joachimwestlund/SignalGenerator/(list of files, cad)

Other CAD files:
3d/case/case.ipt
