joachimwestlund/SignalGenerator/SignalGenerator_schematic.pdf

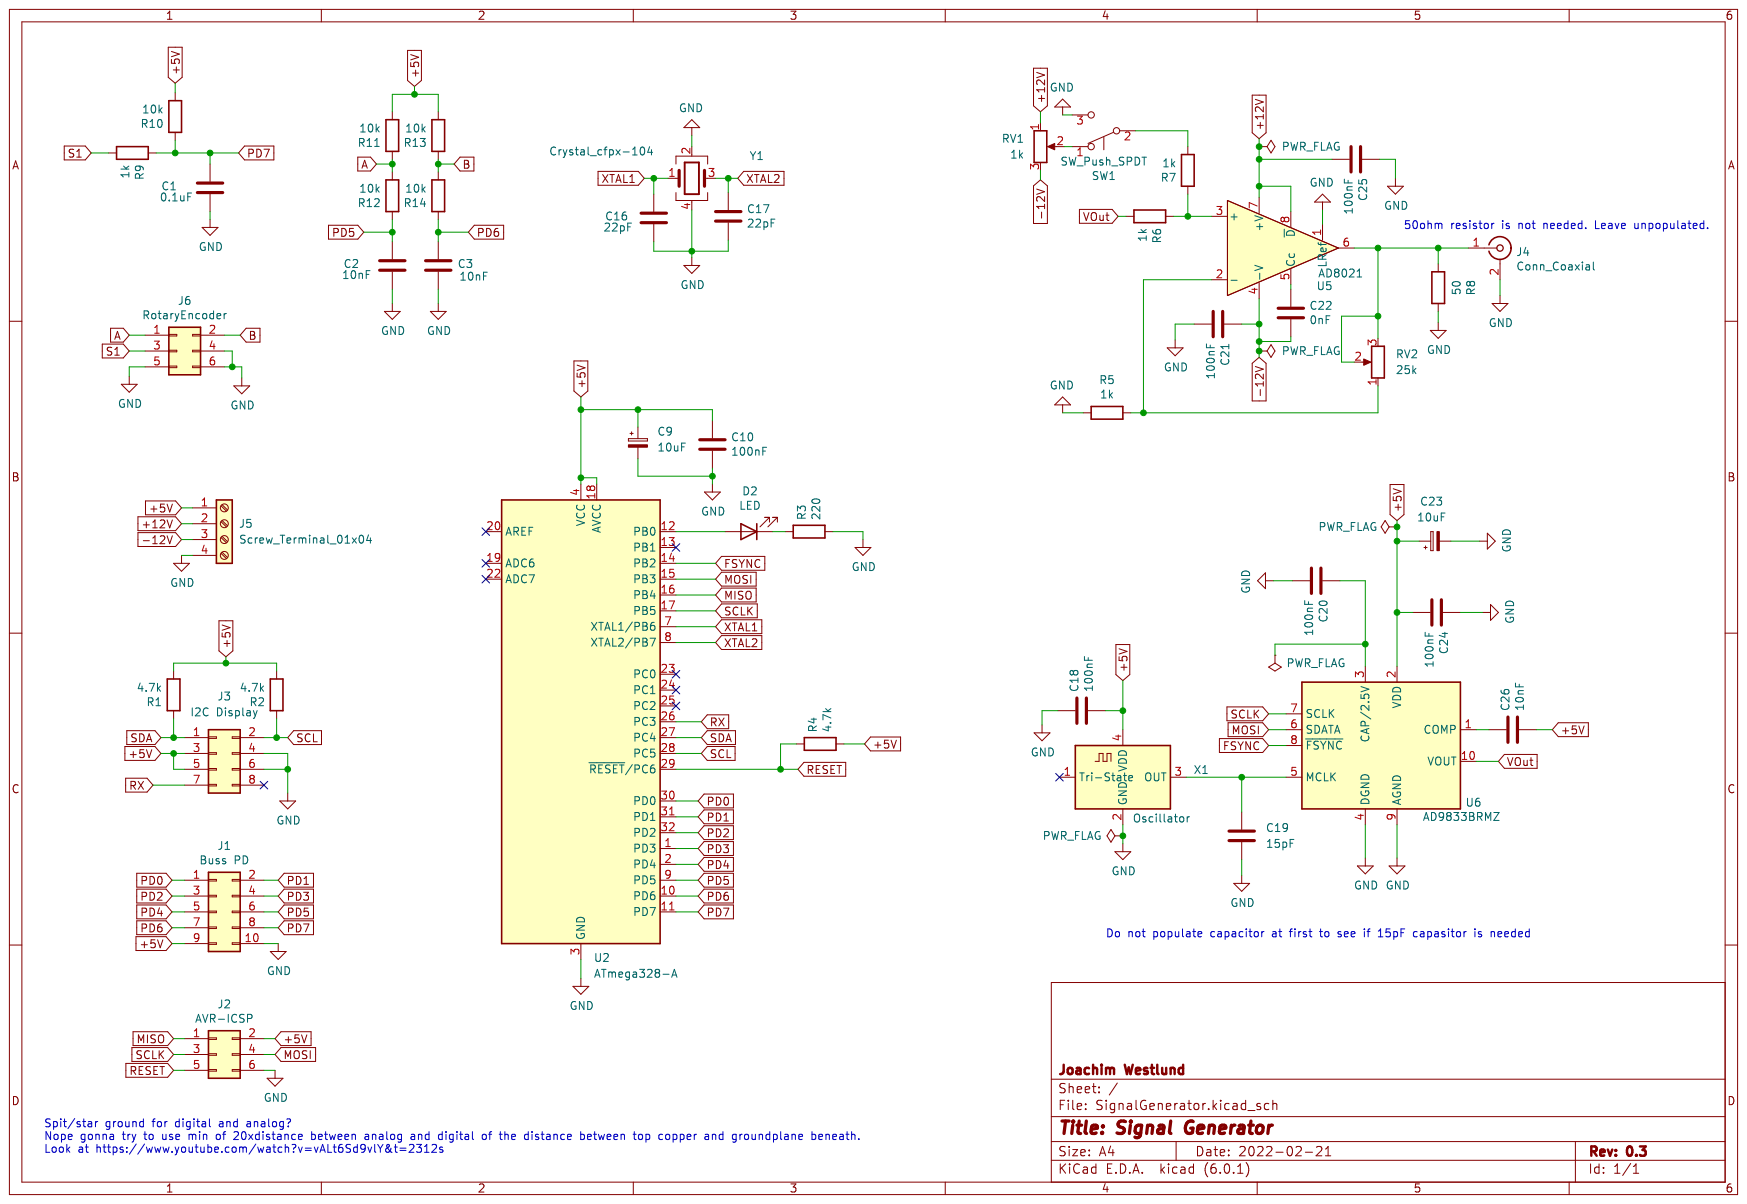
[picture p1: page 1]
