joachimwestlund/SignalGenerator/Sim/amplifier.asc

C1: cap; 1µ
R1: res; 1k
R3: res; 16k
R4: res; 200
U2: AD8021
V1: voltage; 12V
V2: voltage; -12V
V3: voltage; SINE(0 0.6 10meg 0 0 0)
Named nets: 0
.tran 0.1ms
