joachimwestlund/SignalGenerator/Sim/PowerSupply.asc

C1: cap; 2200µF; Rser=0,1
C2: cap; 2200µF; Rser=0.1
D1: diode; MURS320
D2: diode; MURS320
D3: diode; MURS320
D4: diode; MURS320
D5: diode; MURS320
D6: diode; MURS320
D7: diode; MURS320
D8: diode; MURS320
R1: res; 300
R2: res; 300
V1: voltage; SINE(0 12 50 0 0 0 50)
V2: voltage; SINE(0 12 50 0 0 0 50)
Named nets: 0, +12V, -12V, -0V, +0V
.tran 1s
