joachimwestlund/SignalGenerator/(list of files, drawings)

Other design files:
Sim/Design1.ms14
Sim/opamp.ms14
