joachimwestlund/SignalGenerator/SignalGenerator/SignalGenerator.kicad_pcb

## KiCad design SignalGenerator/SignalGenerator.kicad_pcb (2022-03-17)

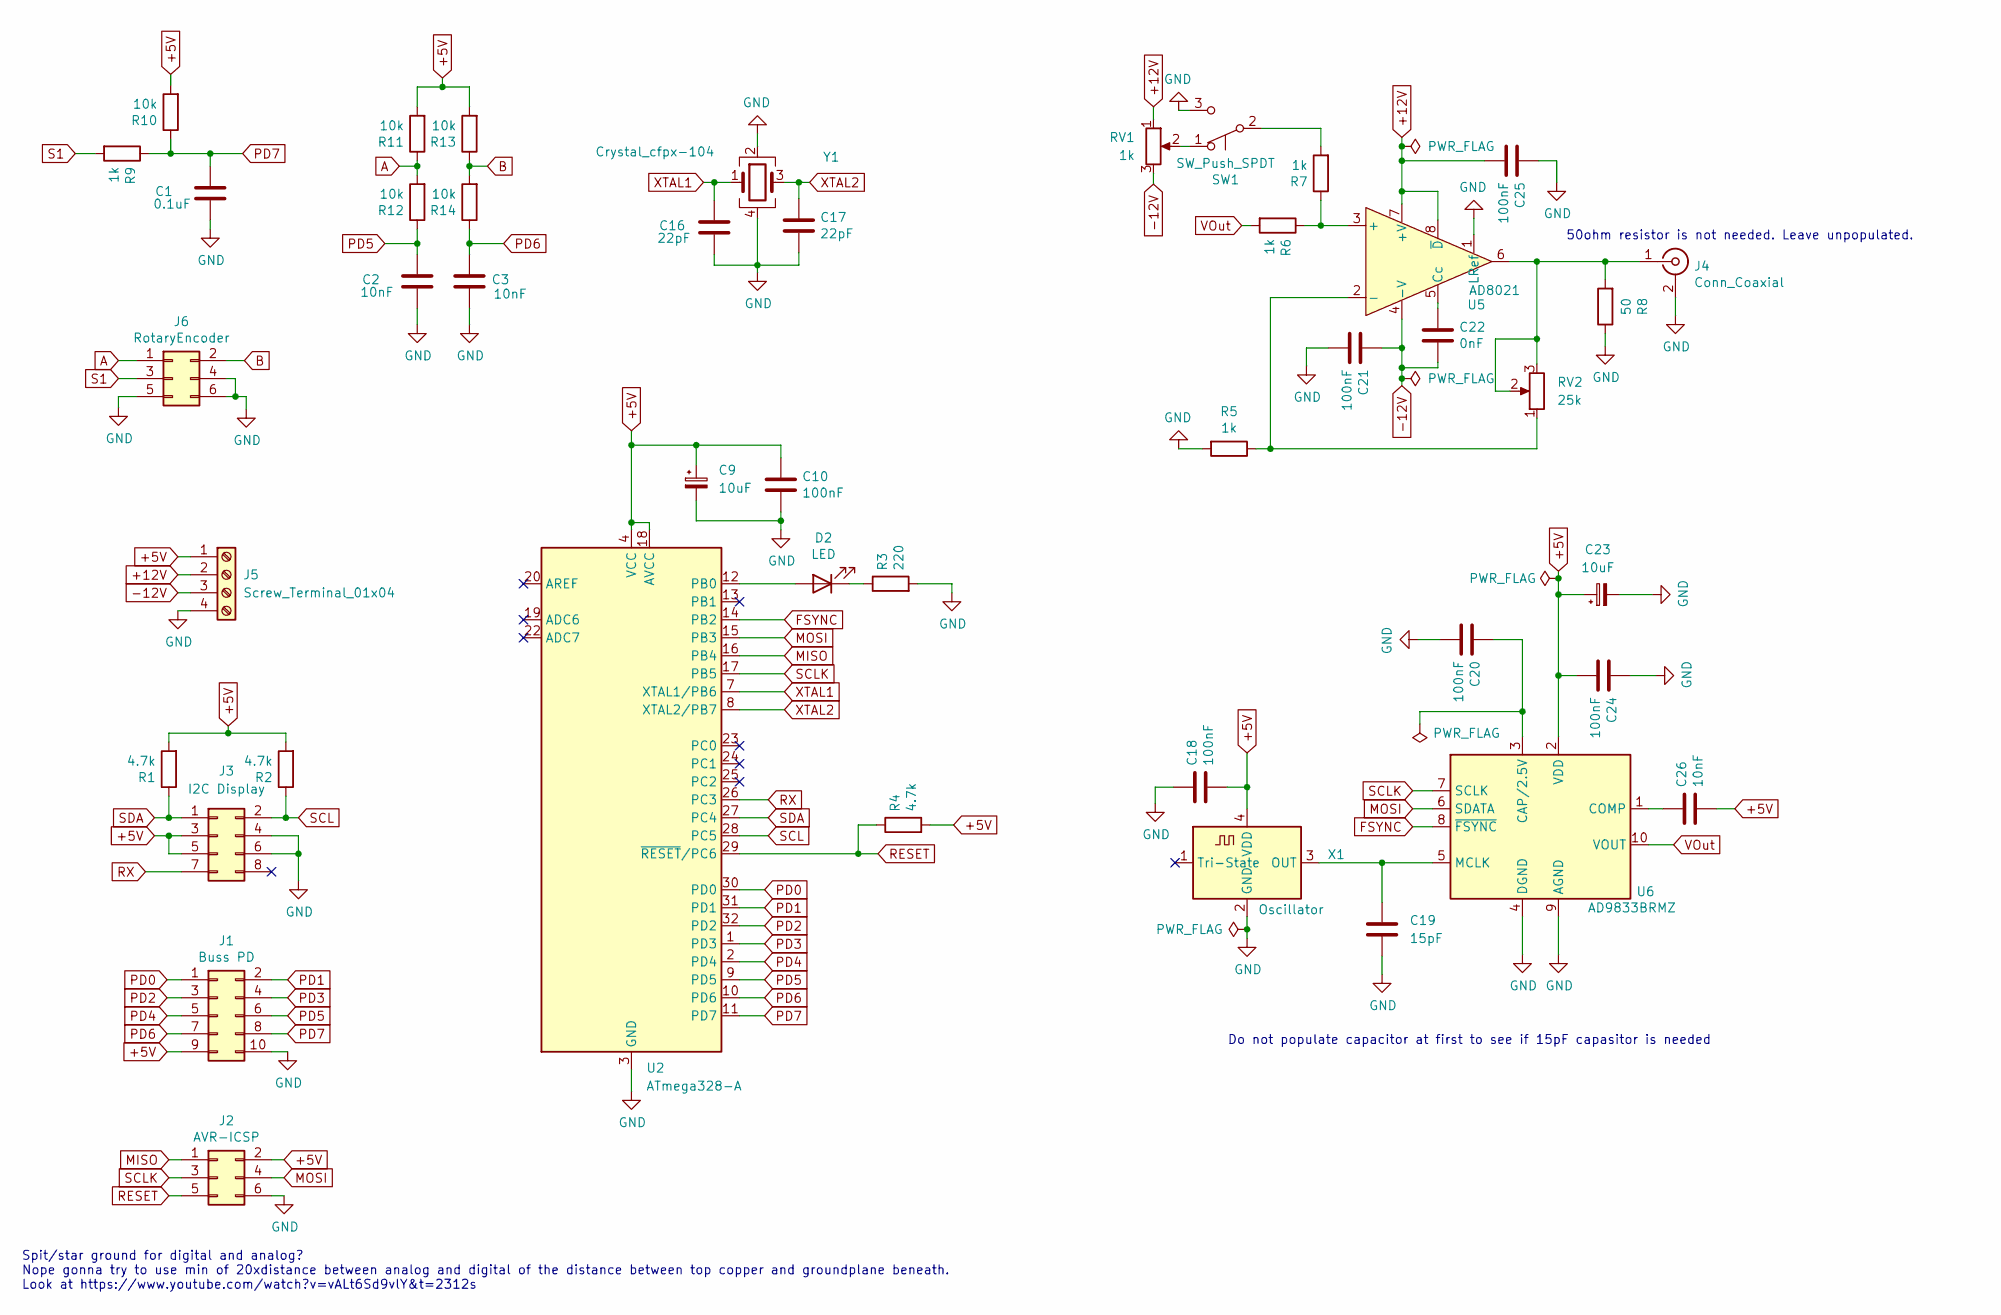
[picture p2: schematic SignalGenerator.kicad_sch, Signal Generator]

Parts:
C1: 0.1uF; C_0805_2012Metric_Pad1.18x1.45mm_HandSolder
C2, C3, C26: 10nF; C_1206_3216Metric_Pad1.33x1.80mm_HandSolder
C9, C23: 10uF; CP_EIA-2012-15_AVX-P_Pad1.30x1.05mm_HandSolder; Manuf.# T529P106M010AAE200; LCSC# C696821
C10, C18, C20, C21, C24, C25: 100nF; C_0805_2012Metric_Pad1.18x1.45mm_HandSolder
C16, C17: 22pF; C_0805_2012Metric_Pad1.18x1.45mm_HandSolder
C19: 15pF; C_0805_2012Metric_Pad1.18x1.45mm_HandSolder
C22: 0nF; C_0805_2012Metric_Pad1.18x1.45mm_HandSolder
D2: LED; C_0805_2012Metric_Pad1.18x1.45mm_HandSolder
J1: Buss PD; PinHeader_2x05_P2.54mm_Vertical
J2: AVR-ICSP; PinHeader_2x03_P2.54mm_Vertical
J3: I2C Display; PinHeader_2x04_P2.54mm_Vertical
J4: Conn_Coaxial; PinHeader_1x02_P2.54mm_Vertical; Manuf.# DOSIN-801-0075; LCSC# C521207
J5: Screw_Terminal_01x04; Altech_AK300_1x04_P5.00mm_45-Degree
J6: RotaryEncoder; PinHeader_2x03_P2.54mm_Vertical
R1, R2, R4: 4.7k; R_0805_2012Metric_Pad1.20x1.40mm_HandSolder
R3: 220; R_1206_3216Metric_Pad1.30x1.75mm_HandSolder
R5, R6, R7, R9: 1k; R_0805_2012Metric_Pad1.20x1.40mm_HandSolder
R8: 50; R_0805_2012Metric_Pad1.20x1.40mm_HandSolder
R10, R11, R12, R13, R14: 10k; R_0805_2012Metric_Pad1.20x1.40mm_HandSolder
RV1: 1k; PinHeader_1x03_P2.54mm_Vertical
RV2: 25k; PinHeader_1x03_P2.54mm_Vertical
SW1: SW_Push_SPDT; PinHeader_1x03_P2.54mm_Vertical
U2: ATmega328-A; TQFP-32_7x7mm_P0.8mm
U5: AD8021; SOIC-8_3.9x4.9mm_P1.27mm; Manuf.# AD8021ARZ; LCSC# C17135
U6: AD9833BRMZ; MSOP-10_3x3mm_P0.5mm; Manuf.# AD9833BRMZ; DigiKey# 505-AD9833BRMZ-ND
X1: Oscillator; Oscillator_SMD_Abracon_ASV-4Pin_7.0x5.1mm_HandSoldering; Manuf.# S7D25.000000A20F30T; LCSC# C387028
Y1: Crystal_cfpx-104; Crystal_SMD_5032-4Pin_5.0x3.2mm Handsolder

Connections:
+5V: C9.1, C10.1, C18.2, C23.1, C24.2, C26.2, J1.9, J2.2, J3.3, J3.5, J5.1, R1.2, R2.2, R4.2, R10.2, R11.2, R13.2, U2.4 (VCC), U2.6 (VCC), U2.18 (AVCC), U6.2 (VDD), X1.4 (VDD)
+12V: C25.2, J5.2, RV1.1, U5.7 (+V), U5.8 (~D)
-12V: C21.1, C22.2, J5.3, RV1.3, U5.4 (-V)
A: J6.1, R11.1, R12.2
B: J6.2, R13.1, R14.2
FSYNC: U2.14 (PB2), U6.8 (~FSYNC)
GND: C1.2, C2.2, C3.2, C9.2, C10.2, C16.2, C17.2, C18.1, C19.2, C20.2, C21.2, C23.2, C24.1, C25.1, J1.10, J2.6, J3.4, J3.6, J4.2 (Ext), J5.4, J6.4, J6.5, J6.6, R3.2, R5.2, R8.1, SW1.3 (C), U2.3 (GND), U2.5 (GND), U2.21 (GND), U5.1 (LRef~), U6.4 (DGND), U6.9 (AGND), X1.2 (GND), Y1.2, Y1.4
MISO: J2.1, U2.16 (PB4)
MOSI: J2.4, U2.15 (PB3), U6.6 (SDATA)
unnamed: C19.1, U6.5 (MCLK), X1.3 (OUT)
unnamed: C20.1, U6.3 (CAP/2.5V)
unnamed: C22.1, U5.5 (Cc)
unnamed: C26.1, U6.1 (COMP)
unnamed: D2.1 (K), R3.1
unnamed: D2.2 (A), U2.12 (PB0)
unnamed: J4.1 (In), R8.2, RV2.2, RV2.3, U5.6
unnamed: R5.1, RV2.1, U5.2 (-)
unnamed: R6.1, R7.1, U5.3 (+)
unnamed: R7.2, SW1.2 (B)
unnamed: RV1.2, SW1.1 (A)
PD0: J1.1, U2.30 (PD0)
PD1: J1.2, U2.31 (PD1)
PD2: J1.3, U2.32 (PD2)
PD3: J1.4, U2.1 (PD3)
PD4: J1.5, U2.2 (PD4)
PD5: C2.1, J1.6, R12.1, U2.9 (PD5)
PD6: C3.1, J1.7, R14.1, U2.10 (PD6)
PD7: C1.1, J1.8, R9.1, R10.1, U2.11 (PD7)
RESET: J2.5, R4.1, U2.29 (~RESET/PC6)
RX: J3.7, U2.26 (PC3)
S1: J6.3, R9.2
SCL: J3.2, R2.1, U2.28 (PC5)
SCLK: J2.3, U2.17 (PB5), U6.7 (SCLK)
SDA: J3.1, R1.1, U2.27 (PC4)
VOut: R6.2, U6.10 (VOUT)
XTAL1: C16.1, U2.7 (XTAL1/PB6), Y1.1
XTAL2: C17.1, U2.8 (XTAL2/PB7), Y1.3

Notes on the sheet:
Spit/star ground for digital and analog? Nope gonna try to use min of 20xdistance between analog and digital of the distance between top copper and groundplane beneath. Look at https://www.youtube.com/watch?v=vALt6Sd9vlY&t=2312s
50ohm resistor is not needed. Leave unpopulated.
Do not populate capacitor at first to see if 15pF capasitor is needed

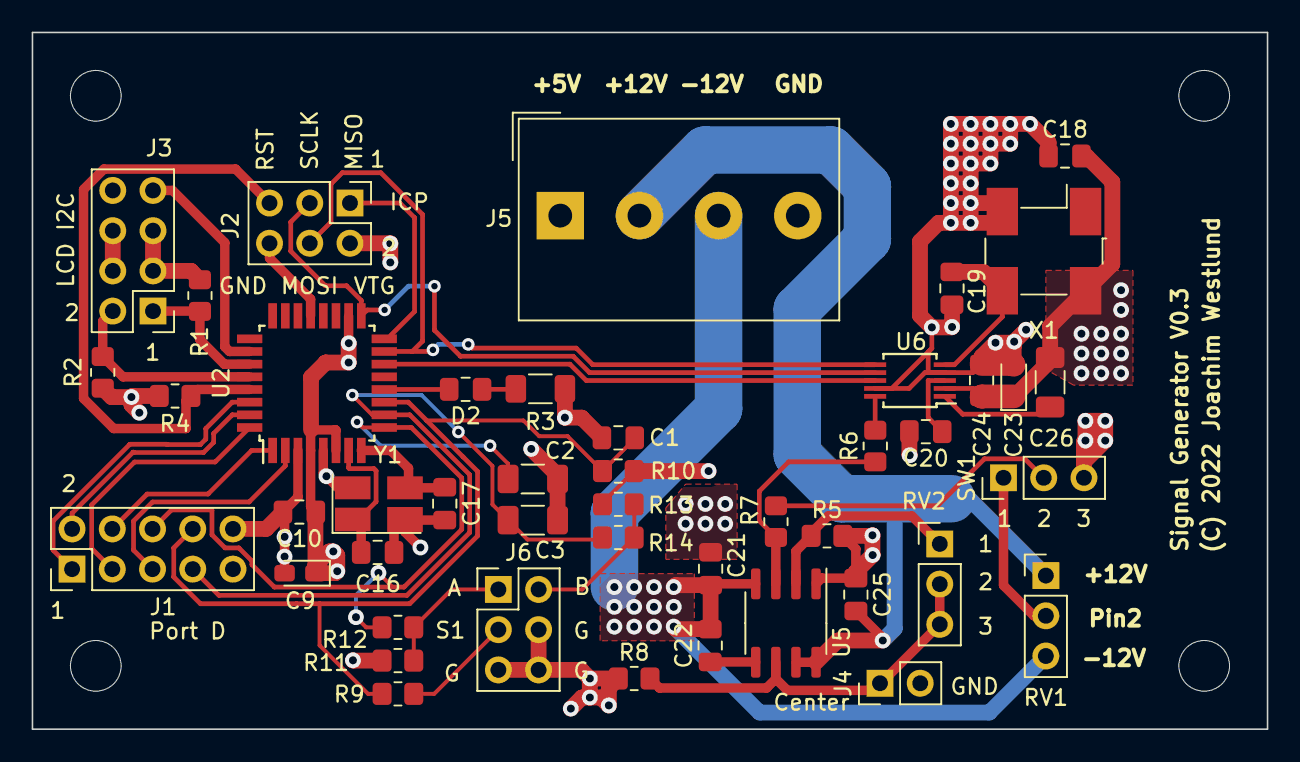
[picture p3: board SignalGenerator.kicad_pcb from above]

Board: 4 copper layers, 78.0 x 44.0 mm, 45 parts (0 on the bottom side), 37 nets.
