joachimwestlund/SignalGenerator/(commit log)

2021-11-09 Adding all the files
    [SignalGenerator.kicad_pcb, SignalGenerator.sch]
2021-11-09 Added DC offset to schematic
    [SignalGenerator.sch]
2021-11-13 doing some small stuff
    [SignalGenerator.sch]
2021-12-05 Made alot off changes. schematics is much closer to done
    [SignalGenerator.sch]
2022-02-21 fixing alot of things
    [SignalGenerator.kicad_sch]
2022-02-21 made some stuff again
    [SignalGenerator.kicad_pcb, SignalGenerator.kicad_sch]
2022-02-25 First real revision to the PCB done.
    [SignalGenerator-B_Cu.gbl, SignalGenerator-B_Mask.gbs, SignalGenerator-B_Paste.gbp, SignalGenerator-B_Silkscreen.gbo, SignalGenerator-Edge_Cuts.gm1, SignalGenerator-F_Cu.gtl, SignalGenerator-F_Mask.gts, SignalGenerator-F_Paste.gtp]
2022-03-11 started to code interrupts for rotary encoder
2022-03-13 Got the I2C working a bit.
2022-03-13 I2C now writes chars and strings to my LCD
2022-03-15 Separeated powersupply to it's own project. Did some stuff to the reset circuit.
    [PowerSupply.kicad_pcb, PowerSupply.kicad_sch, SignalGenerator.kicad_pcb, SignalGenerator.kicad_sch]
2022-03-15 LF to CRLF fix i think
    [PowerSupply.kicad_sch, SignalGenerator.kicad_sch]
2022-03-15 new logo
    [SignalGenerator.kicad_pcb]
2022-03-15 gerbers regenerated
    [SignalGenerator-B_Cu.gbl, SignalGenerator-B_Mask.gbs, SignalGenerator-B_Paste.gbp, SignalGenerator-B_Silkscreen.gbo, SignalGenerator-Edge_Cuts.gm1, SignalGenerator-F_Cu.gtl, SignalGenerator-F_Mask.gts, SignalGenerator-F_Paste.gtp]
2022-03-15 added rotary encoder stuff
    [SignalGenerator-B_Cu.gbl, SignalGenerator-B_Mask.gbs, SignalGenerator-B_Paste.gbp, SignalGenerator-B_Silkscreen.gbo, SignalGenerator-Edge_Cuts.gm1, SignalGenerator-F_Cu.gtl, SignalGenerator-F_Mask.gts, SignalGenerator-F_Paste.gtp]
2022-03-16 Did alot of changes to my vias. jlcpcb does not support blind or buried vias
    [SignalGenerator-B_Cu.gbl, SignalGenerator-B_Mask.gbs, SignalGenerator-B_Paste.gbp, SignalGenerator-B_Silkscreen.gbo, SignalGenerator-Edge_Cuts.gm1, SignalGenerator-F_Cu.gtl, SignalGenerator-F_Mask.gts, SignalGenerator-F_Paste.gtp]
2022-03-17 merging drill-files to one for jlcpcb
    [SignalGenerator.kicad_pcb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]
2022-03-24 trying to code for the signal generator and some gerber updates
    [SignalGenerator-B_Cu.gbl, SignalGenerator-B_Mask.gbs, SignalGenerator-B_Paste.gbp, SignalGenerator-B_Silkscreen.gbo, SignalGenerator-Edge_Cuts.gm1, SignalGenerator-F_Cu.gtl, SignalGenerator-F_Mask.gts, SignalGenerator-F_Paste.gtp]
2022-03-25 Stuff on rotary encoder and LCD
2022-03-26 Rotary encoder works
2022-03-26 Added rotary encoder button
2022-04-02 testing led in software
2022-04-20 adding stuff
    [case.ipt]
2022-04-21 adding code for AD9833. Not working yet
    [AD9833.c, AD9833.h, SPI.c, main.c]
2022-07-08 Debuging SPI
2022-07-21 Added schematic pdf and some SPI debuging
2022-10-02 debug project to se what was wrong with SPI code. Now the avr talks and sets up ad9833 correctly
    [AD9833.c, AD9833.h, SPI.c, SPI.h, main.c]
