joachimwestlund/SignalGenerator/(notices)

Notices in the files:
SignalGenerator/SignalGenerator.kicad_pcb:
(C) 2022 Joachim Westlund
